hwxiu1223/inverted-pendulum/Website/Images/mag-encoder-assy.png

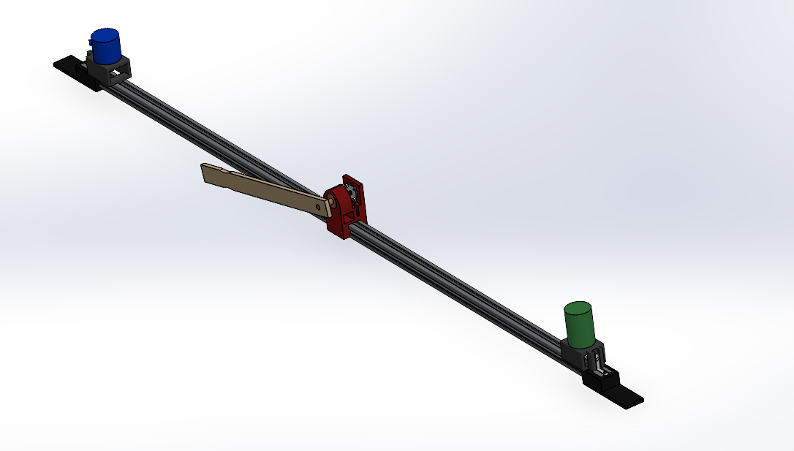
Website/Images/mag-encoder-assy.png
