hwxiu1223/inverted-pendulum/Website/Images/mag-encoder-mount.jpg

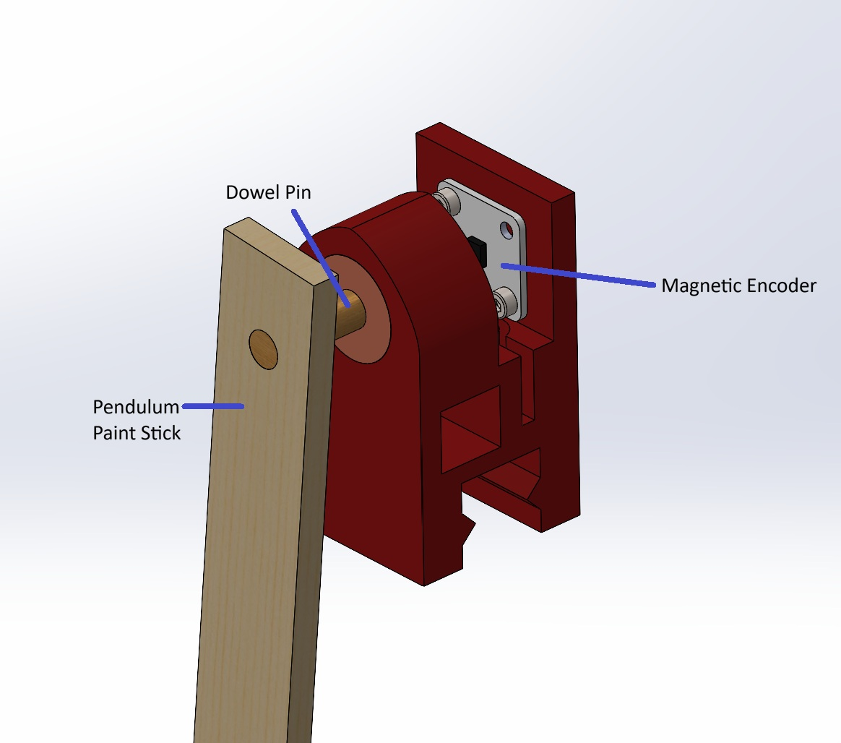
Website/Images/mag-encoder-mount.jpg
