hwxiu1223/inverted-pendulum/Website/Images/motor-housing.jpg

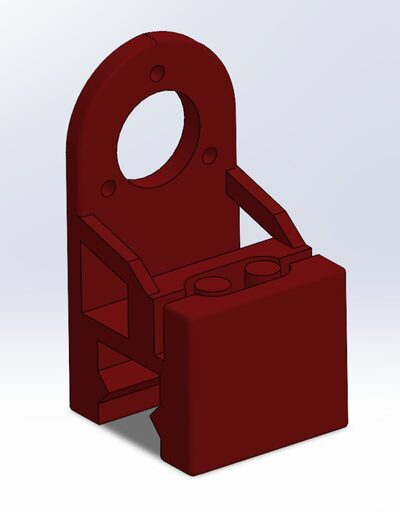
Website/Images/motor-housing.jpg
