hwxiu1223/inverted-pendulum/Website/Images/motor-mount-2.jpg

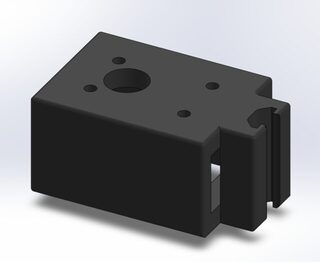
Website/Images/motor-mount-2.jpg
