hwxiu1223/inverted-pendulum/CAD/cartParts/CartAssy.SLDASM

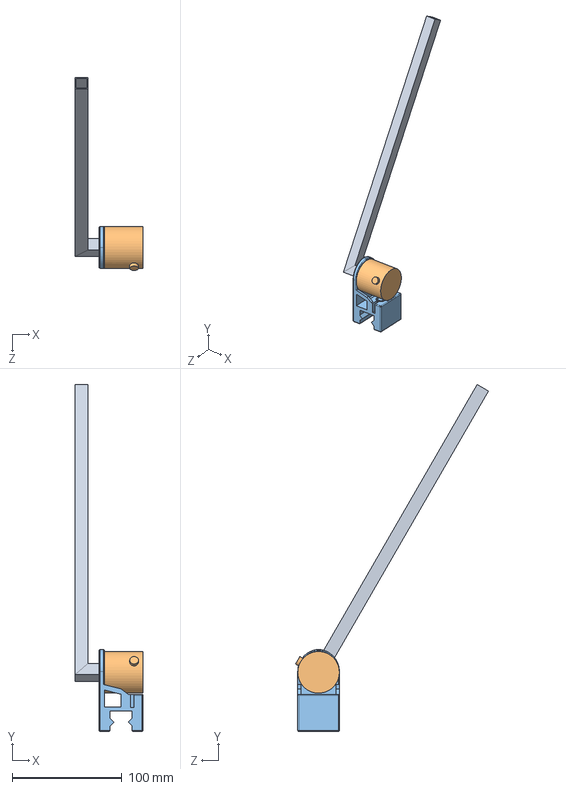
[picture p6: CAD file, 2026-09-08]
CAD/cartParts/CartAssy.SLDASM
62.2 x 316.8 x 176.2 mm
Cart
RotaryEncoder24
pendulum
