hwxiu1223/inverted-pendulum/CAD/invertedPendyAssy24.SLDASM

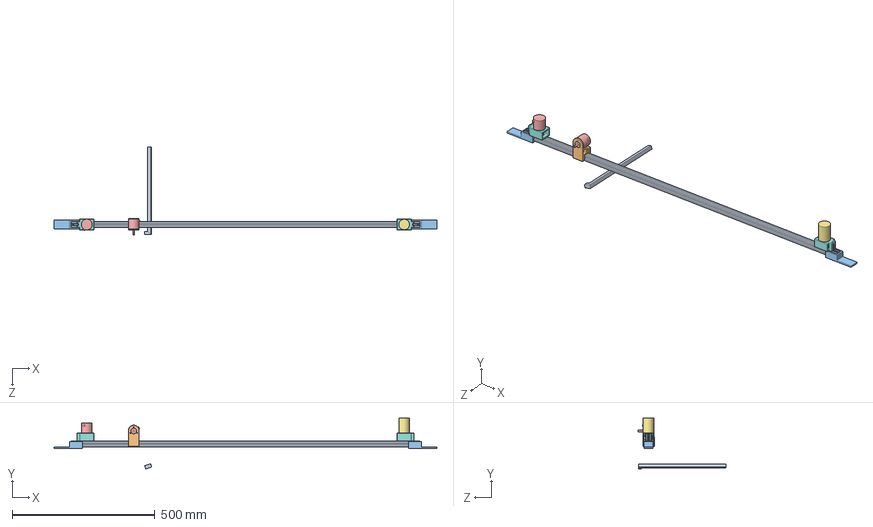
[picture p7: CAD file, 2026-09-07]
CAD/invertedPendyAssy24.SLDASM
1339.2 x 178.0 x 306.4 mm
rail24
Mounts24 x 2
Motor24
L-Bracket24 x 2
RotaryEncoder24 x 2
Pulley_BLOG x 2
rail_stand x 2
Cart
Pendulum
