hwxiu1223/inverted-pendulum/CAD/invertedPendyAssy.SLDASM

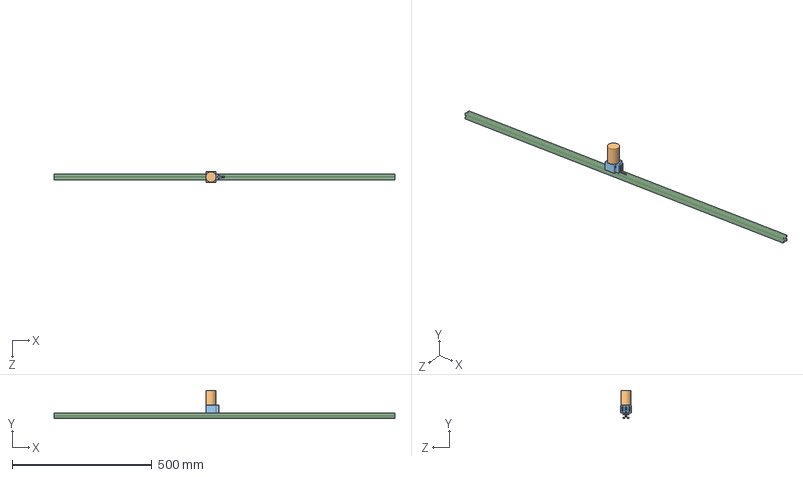
[picture p8: CAD file, 2026-07-01]
CAD/invertedPendyAssy.SLDASM
1219.2 x 101.0 x 38.0 mm
rail
MotorMount
Motor
L-Bracket
