hwxiu1223/inverted-pendulum/CAD/cartParts/Cart.SLDPRT

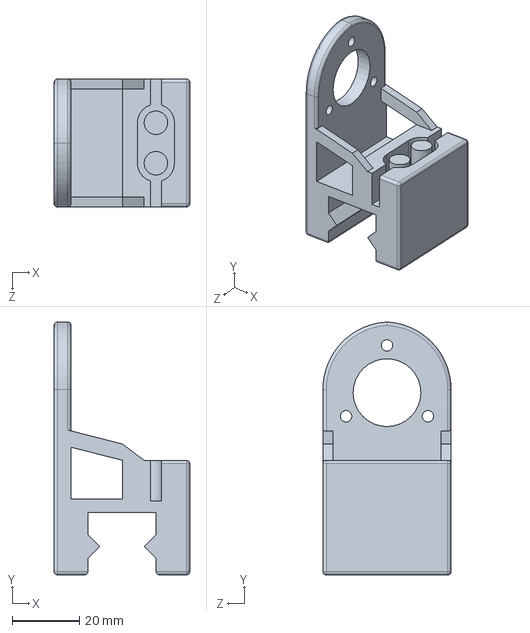
[picture p9: CAD file, 2026-10-07]
CAD/cartParts/Cart.SLDPRT
40.2 x 75.0 x 38.0 mm
