hwxiu1223/inverted-pendulum/CAD/pendulum.SLDPRT

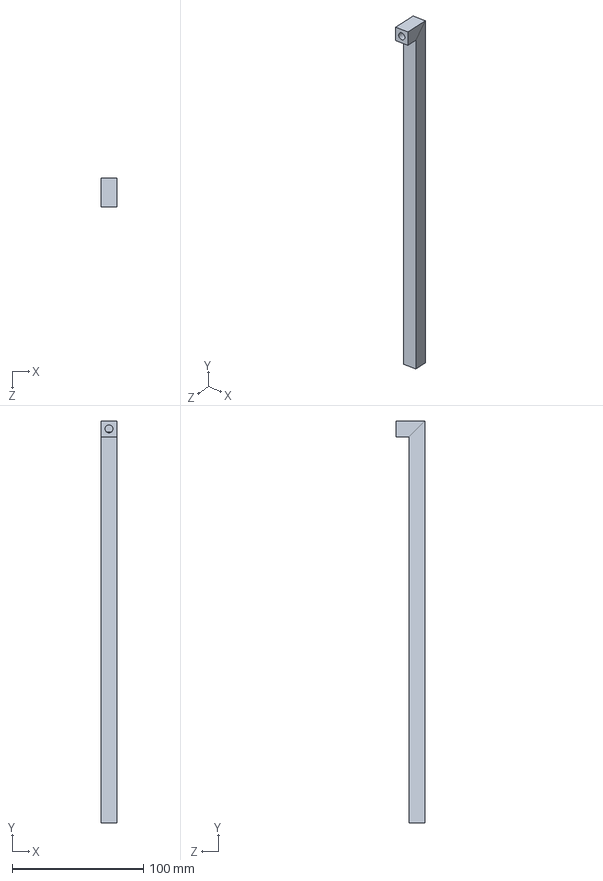
[picture p10: CAD file, 2026-09-08]
CAD/pendulum.SLDPRT
12.0 x 306.0 x 22.0 mm
