hwxiu1223/inverted-pendulum/CAD/STL/Cart_CylindricalEncoder.3mf

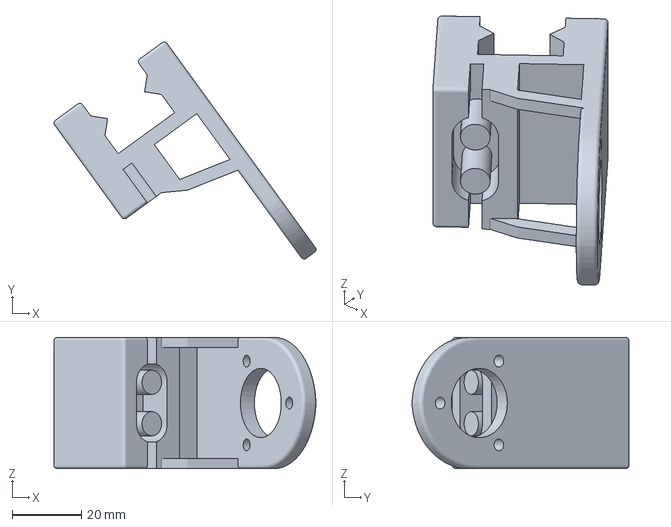
[picture p11: CAD file, 2026-09-07]
CAD/STL/Cart_CylindricalEncoder.3mf
75.8 x 62.8 x 38.0 mm
