hwxiu1223/inverted-pendulum/CAD/STL/Cart.3mf

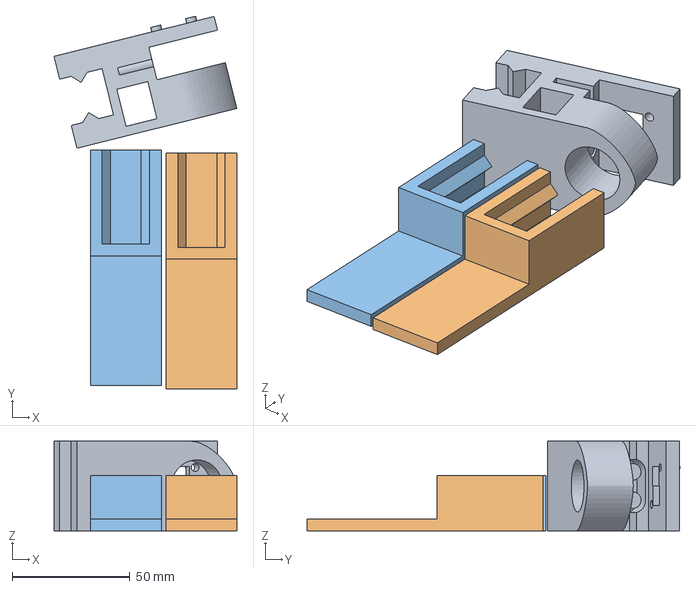
[picture p12: CAD file, 2026-09-04]
CAD/STL/Cart.3mf
77.7 x 158.1 x 38.0 mm
Cart.STL
rail_stand.STL x 2
