hwxiu1223/inverted-pendulum/CAD/cartParts/Pendulum.SLDPRT

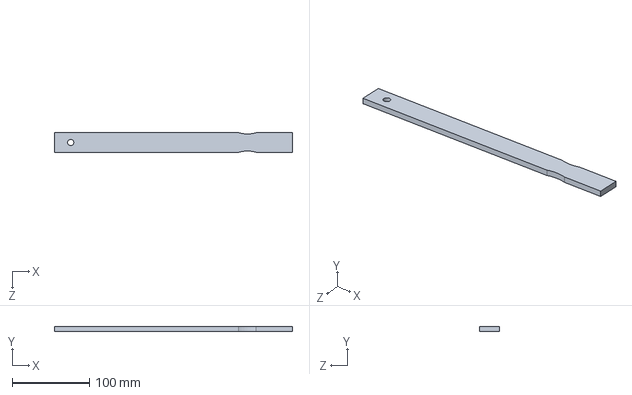
[picture p13: CAD file, 2026-09-07]
CAD/cartParts/Pendulum.SLDPRT
307.9 x 6.35 x 25.4 mm
