hwxiu1223/inverted-pendulum/CAD/Motor24.SLDPRT

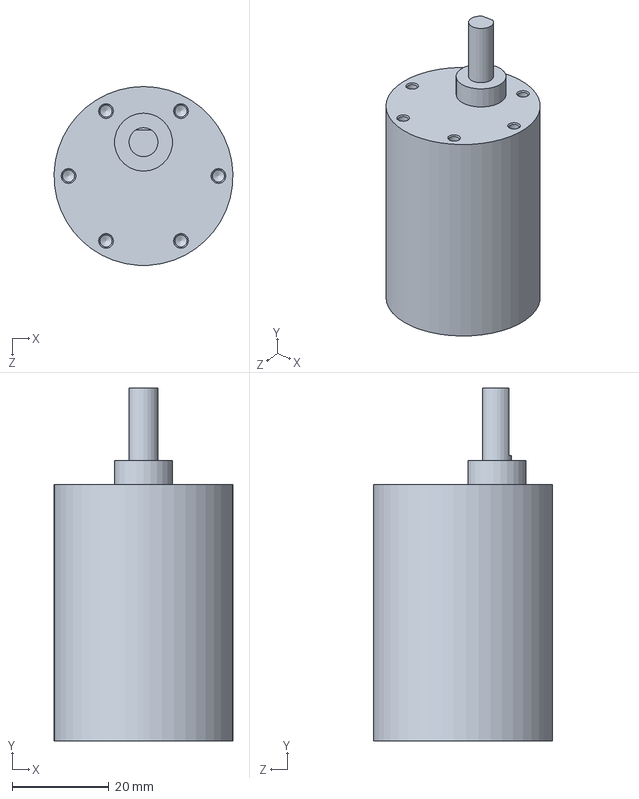
[picture p14: CAD file, 2026-09-07]
CAD/Motor24.SLDPRT
37.0 x 73.0 x 37.0 mm
