hwxiu1223/inverted-pendulum/CAD/STL/EncoderMountRecHole.STL

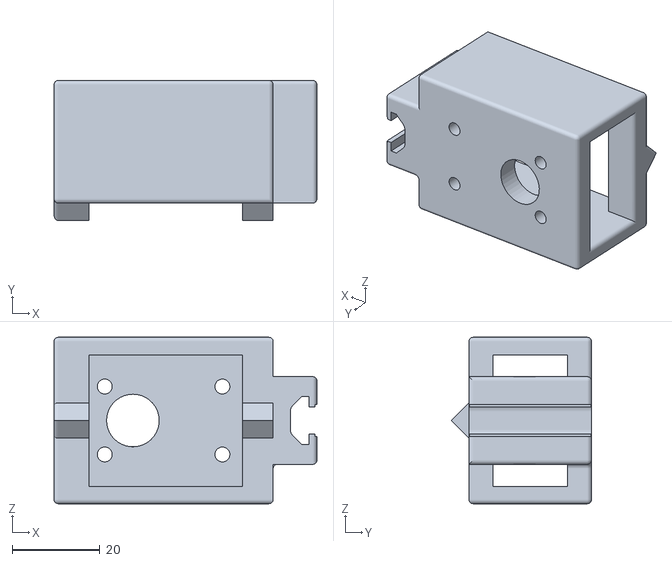
[picture p15: CAD file, 2026-08-17]
CAD/STL/EncoderMountRecHole.STL
60.0 x 32.0 x 38.0
