hwxiu1223/inverted-pendulum/CAD/cartParts/Rod.SLDPRT

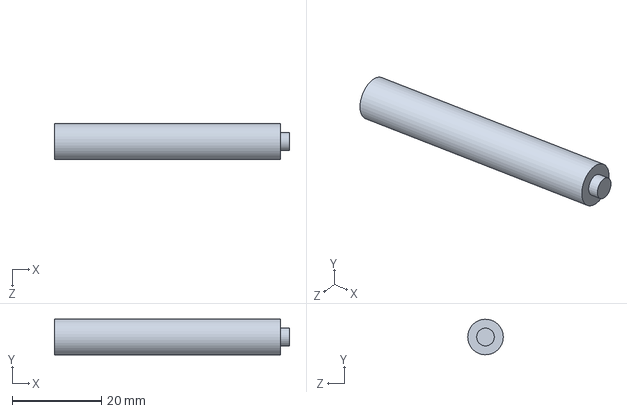
[picture p16: CAD file, 2026-09-07]
CAD/cartParts/Rod.SLDPRT
52.8 x 7.99 x 8.00 mm
