hwxiu1223/inverted-pendulum/CAD/STL/MotorMountRecHole.STL

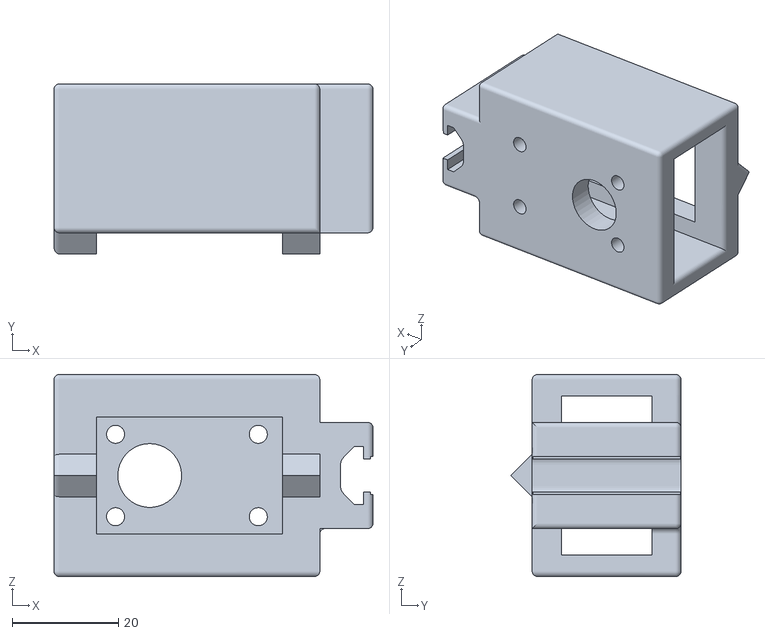
[picture p17: CAD file, 2026-08-17]
CAD/STL/MotorMountRecHole.STL
60.0 x 32.0 x 38.0
