hwxiu1223/inverted-pendulum/CAD/cartParts/MagneticEncoder.SLDPRT

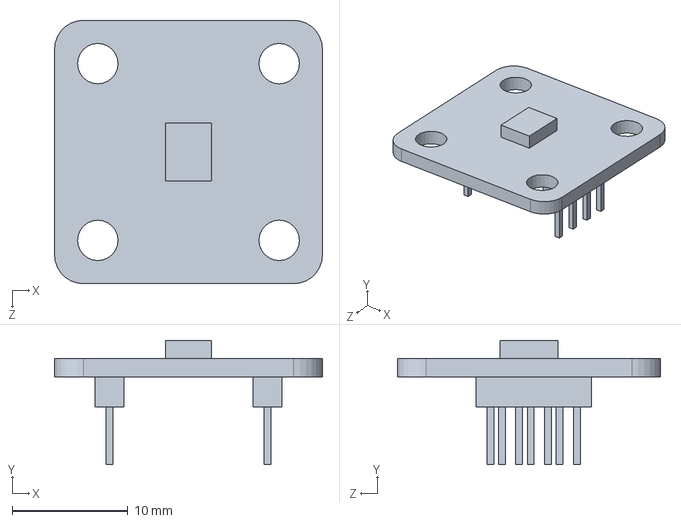
[picture p18: CAD file, 2026-07-24]
CAD/cartParts/MagneticEncoder.SLDPRT
23.2 x 10.8 x 22.8 mm
