hwxiu1223/inverted-pendulum/CAD/rail24.SLDPRT

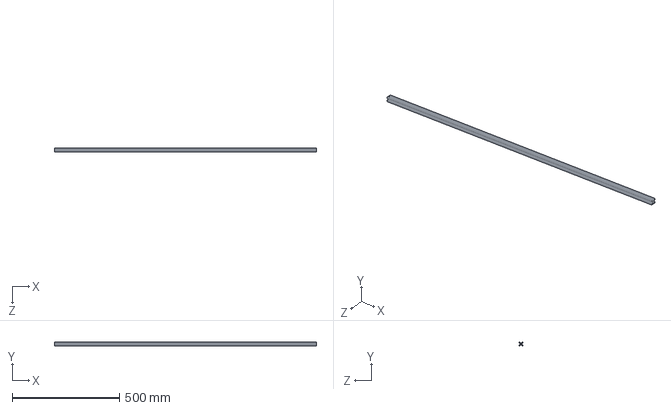
[picture p19: CAD file, 2026-09-07]
CAD/rail24.SLDPRT
1219.2 x 20.0 x 20.0 mm
