hwxiu1223/inverted-pendulum/CAD/cartParts/ballBearing.SLDPRT

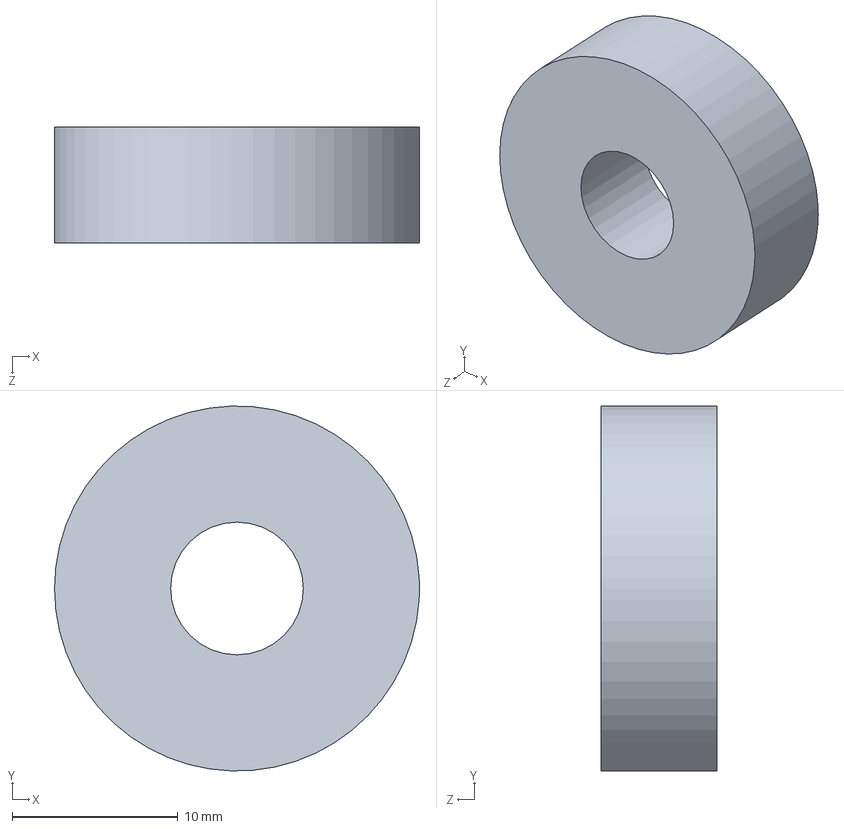
[picture p20: CAD file, 2026-07-21]
CAD/cartParts/ballBearing.SLDPRT
22.0 x 22.0 x 7.00 mm
