hwxiu1223/inverted-pendulum/CAD/rail_stand.SLDPRT

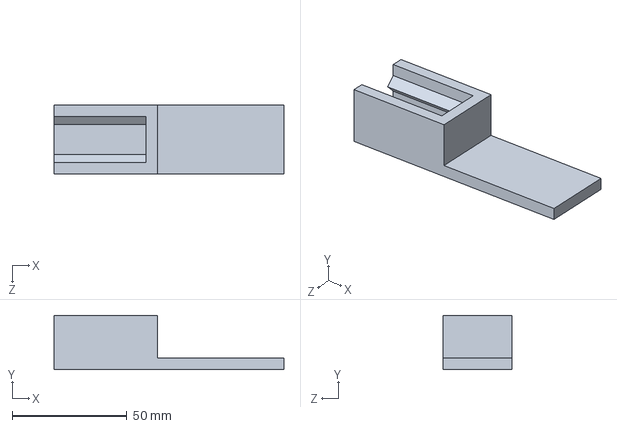
[picture p21: CAD file, 2026-09-07]
CAD/rail_stand.SLDPRT
100.0 x 23.5 x 30.1 mm
