hwxiu1223/inverted-pendulum/CAD/motorpulley.SLDPRT

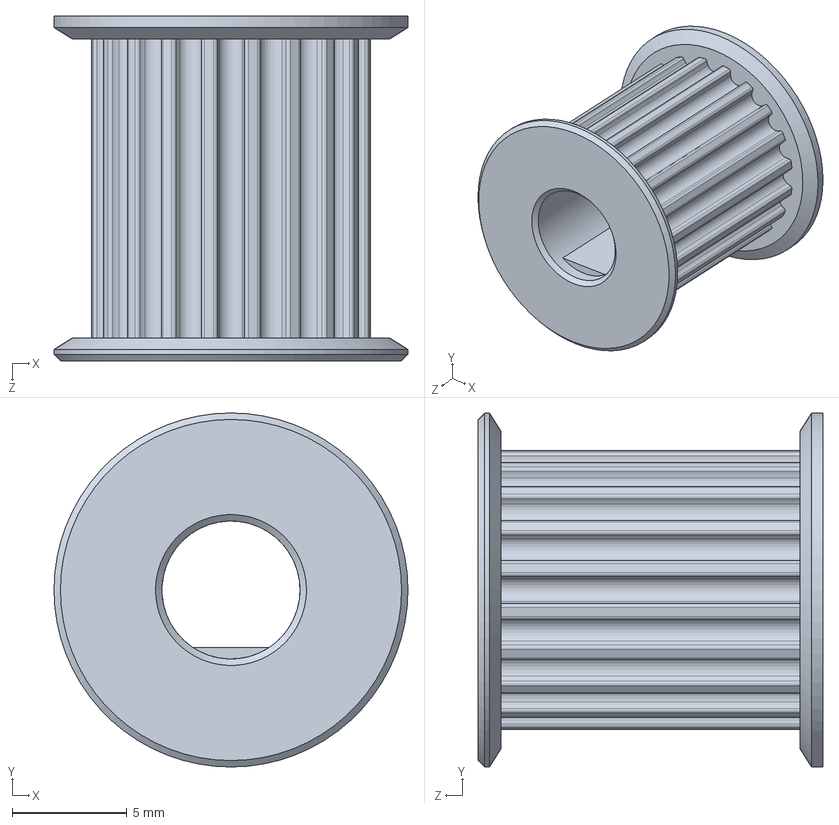
[picture p22: CAD file, 2026-08-18]
CAD/motorpulley.SLDPRT
15.4 x 15.4 x 15.0 mm
