hwxiu1223/inverted-pendulum/CAD/RotaryEncoder24.SLDPRT

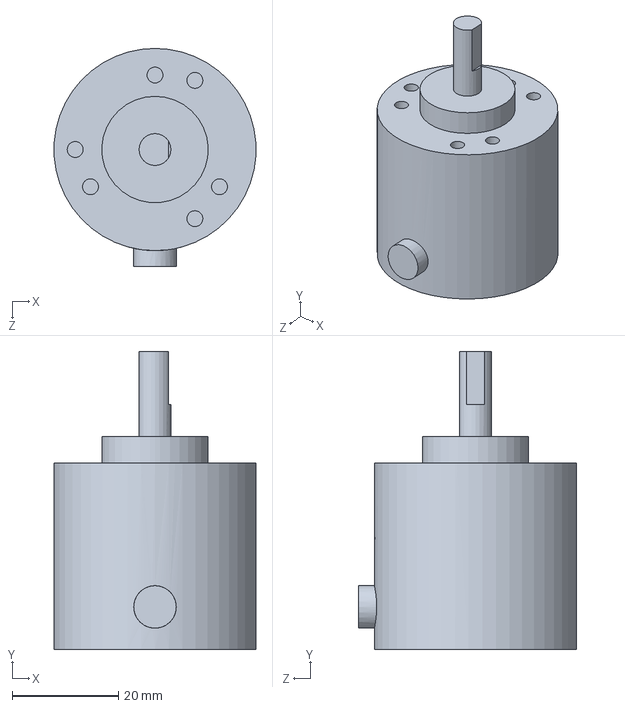
[picture p23: CAD file, 2026-08-16]
CAD/RotaryEncoder24.SLDPRT
37.9 x 56.0 x 41.0 mm
