hwxiu1223/inverted-pendulum/CAD/Pulley_BLOG.SLDPRT

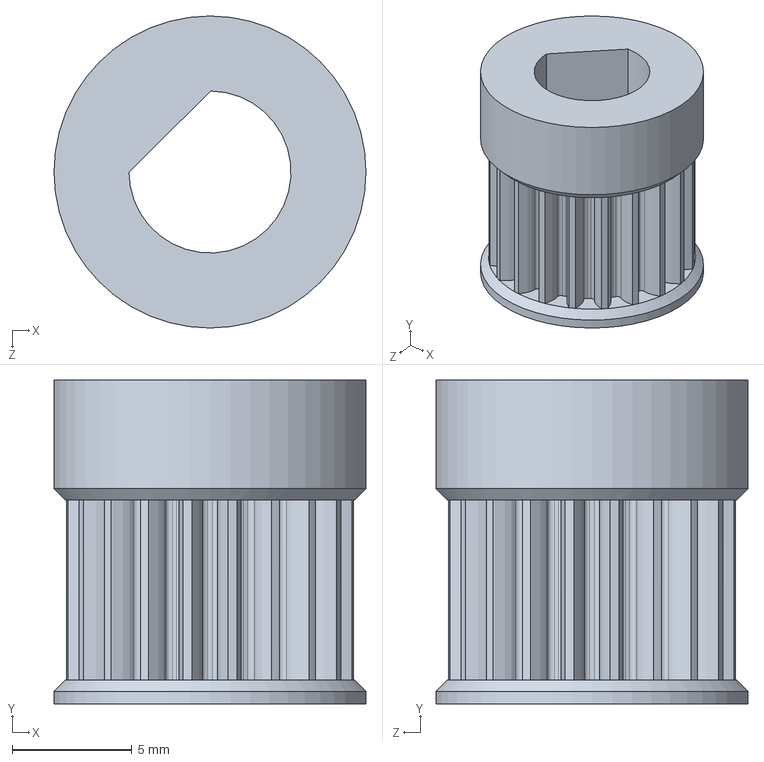
[picture p24: CAD file, 2026-08-16]
CAD/Pulley_BLOG.SLDPRT
13.0 x 13.5 x 13.0 mm
