hwxiu1223/inverted-pendulum/CAD/belt.SLDPRT

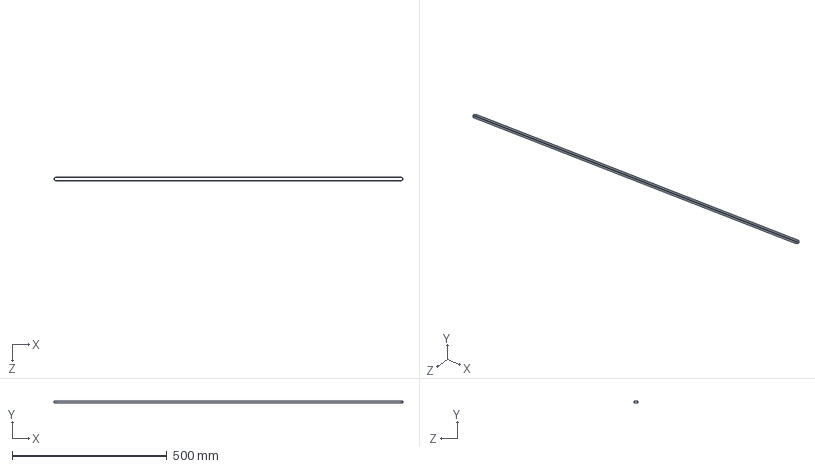
[picture p25: CAD file, 2026-07-25]
CAD/belt.SLDPRT
1127.9 x 5.00 x 12.0 mm
