hwxiu1223/inverted-pendulum/CAD/MotorMount24.SLDPRT

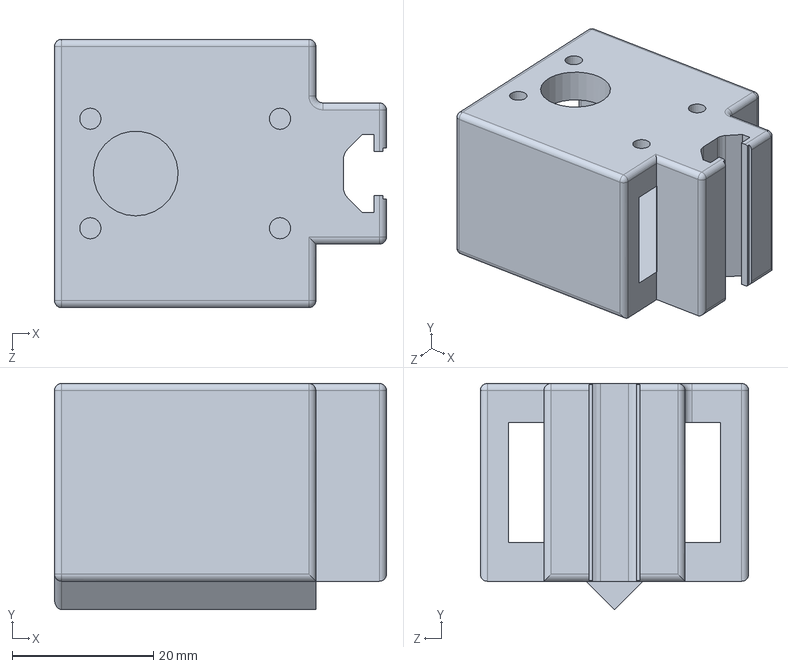
[picture p26: CAD file, 2026-07-17]
CAD/MotorMount24.SLDPRT
47.0 x 32.0 x 38.0 mm
