hwxiu1223/inverted-pendulum/CAD/L-Bracket24.SLDPRT

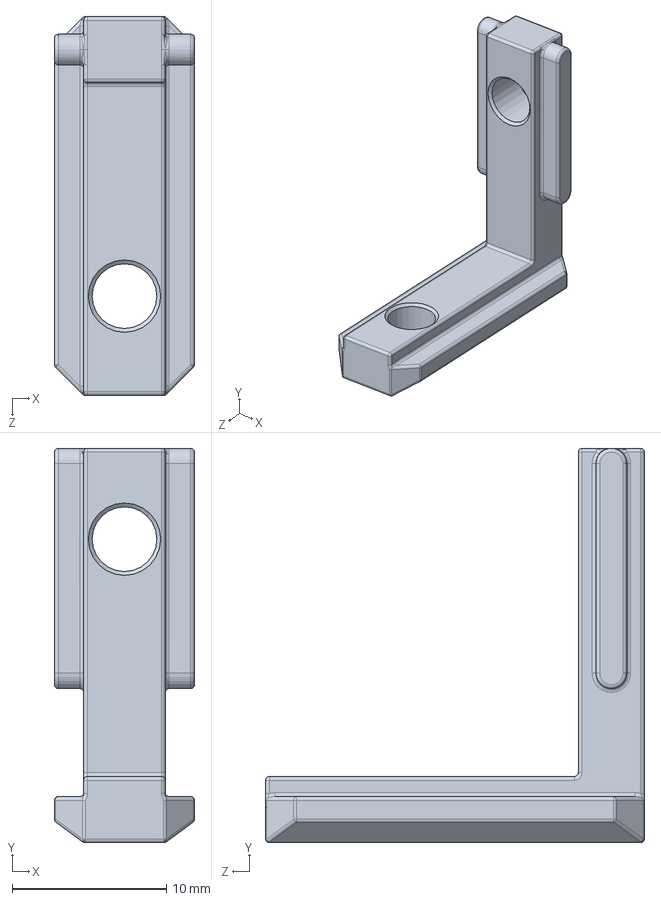
[picture p27: CAD file, 2026-07-17]
CAD/L-Bracket24.SLDPRT
9.10 x 25.6 x 24.6 mm
