hwxiu1223/inverted-pendulum/(list of files, cad)

Other CAD files:
CAD/Mounts24.SLDPRT
CAD/MotorMount.SLDPRT
CAD/Motor.SLDPRT
CAD/L-Bracket.SLDPRT
CAD/rail.SLDPRT
CAD/3764N107_High-Strength Gt Timing Belt PulleyMODDED.SLDPRT
CAD/STL/3764N107_High-Strength Gt Timing Belt PulleyMODDED.3mf
CAD/STL/3764N107_High-Strength Gt Timing Belt PulleyMODDED.STL
CAD/STL/Cart.STL
CAD/STL/Cart_CylindricalEncoder.STL
CAD/STL/L-Bracket.3mf
CAD/STL/L-Bracket.STL
CAD/STL/MotorMount.STL
CAD/STL/Mounts24.STL
CAD/STL/motorpulley.3mf
CAD/STL/motorpulley.STL
CAD/STL/pendulum.STL
CAD/STL/rail_stand.STL
