hwxiu1223/inverted-pendulum/Python/config.example.py

# Windows: 'COM3', 'COM4' etc. | Mac/Linux: '/dev/tty.usbmodem...' or '/dev/ttyUSB0'
COM_PORT = 'COM3'

# COPY THIS TO YOUR TERMINAL: cp Python/config.example.py Python/config.py
# THEN PUT CORRECT COM PORT IN config.py
