hwxiu1223/inverted-pendulum/(commit log)

2026-06-26 Create rail.SLDPRT
    Rail for the SOLIDWORKS assembly and to give an example to Evan
2026-06-30 Simulation fixed! 👍
2026-06-30 Motor & Mount
    Mount not finished yet
2026-06-30 Imported motor driver sample code and started on motor control code
2026-07-01 Delete CAD/Motor.SLDPRT
    Adding new files
2026-07-01 Delete CAD/MotorMount.SLDPRT
    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
2026-07-01 SolidWorks parts & Assembly
    If you wanna change up this stuff, just edit it and replace it.
2026-07-17 finished rotary encoder model
2026-07-21 cart parts & assembly, unfinished, Version 2025
2026-07-23 added encoder mount, Mounts has two configurations
2026-07-24 Newer Cart Assembly
    Added rotary encoder mount, space for belt, and lowered material costs (Still needs modifications to fit belt)
2026-07-24 finished setup and code for magnetic encoder, established comm protocol between python and arduino over serial
2026-07-24 Pulley and belt
2026-07-25 Update Cart.SLDPRT
    Added belt holes on cart
2026-07-25 added pulley
2026-08-10 Created STL file for Cart
2026-08-12 put magnetic encoder and motor together
2026-08-16 New Cart Model
    Increased Encoder Hole Size, Increased space for belt
2026-08-16 Fixed pulley fitting
2026-08-16 Extra space for pulley fitting
2026-08-17 Rectangle Hole in Mounts
2026-08-18 Created pulley specifically for motor
2026-08-19 base rotary encoder code
2026-08-19 Ported encoder code to main
2026-08-19 arduino startup sequence code
2026-08-19 added the save encoder count stuff with keyboard key s
2026-08-19 fixed terminal printing, added locking function to keep cart bounded within 0-30000
2026-08-30 Adjusted Parameters
    Changed length of pendulum to account for it not having a weight attached at the end.
2026-09-01 Corrected Motor Pulley
2026-09-01 something happened to arduino
2026-09-01 BIG MATLAB UPDATE
    Fixed asymmetry/directional issues with initial u value
    Made draw_cartpend properly scaled
    Added back in and adjusted frictional forces to add more realism
    Added additional parameters to pendsys (limitations of motor)
    Added track limits to hybrid_controller and pendsys
    Added motor force ceiling to hybrid_controller
2026-09-02 fixed encoder bug, validated encoder count saving, pressing spacebar now quits program too
2026-09-02 smoothed centering function, added reset enc count function to reset stored encoder count on arduino and in txt file to 0, added hardware resetso arduino automatically resets when stopping python scr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
2026-09-03 Modeled Rail Stands
    May need checks on tolerances and fitting
2026-09-08 cross my heart hope to die idk
2026-09-19 PID/MPC
    Start development of PID controller and MPC
